ke0ff/hm133/hm151_keys_sm.jpg

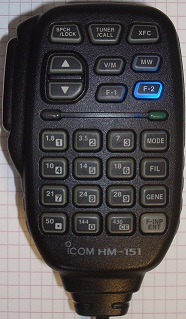
hm151_keys_sm.jpg
