ke0ff/hm133/hm151.jpg

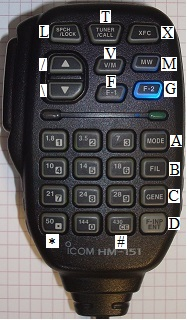
hm151.jpg
