ke0ff/hm133/F53x Software_HM133-WR_04/readme.txt

This project repo contains the SW and some of the HW artifacts for an SiLabs C8051F531-based MCU project to interface an ICOM HM-133 (or HM-151)
microphone to an older transciever using a wired remote protocol.  The source code was compiled and debugged using the Kiel/SiLabs tool-set.
