ke0ff/hm133/bt_host.jpg

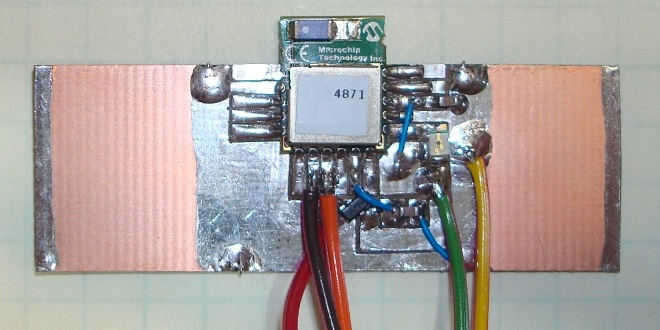
bt_host.jpg
