ke0ff/hm133/bt_remote.jpg

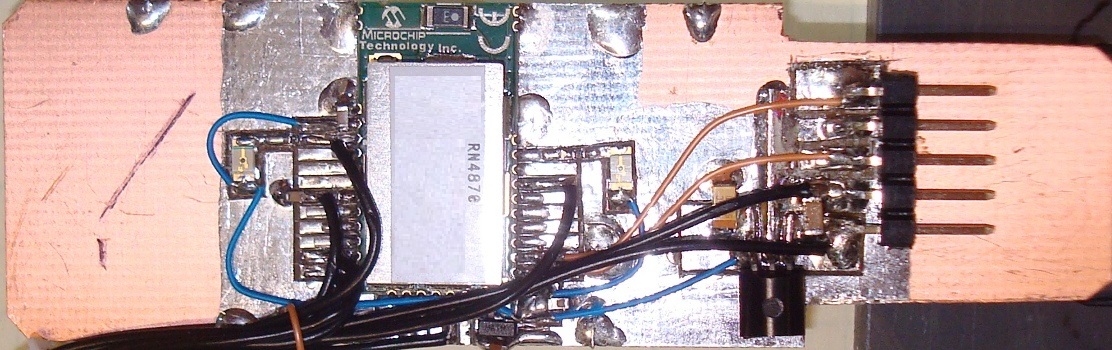
bt_remote.jpg
