ke0ff/hm133/ch901.jpg

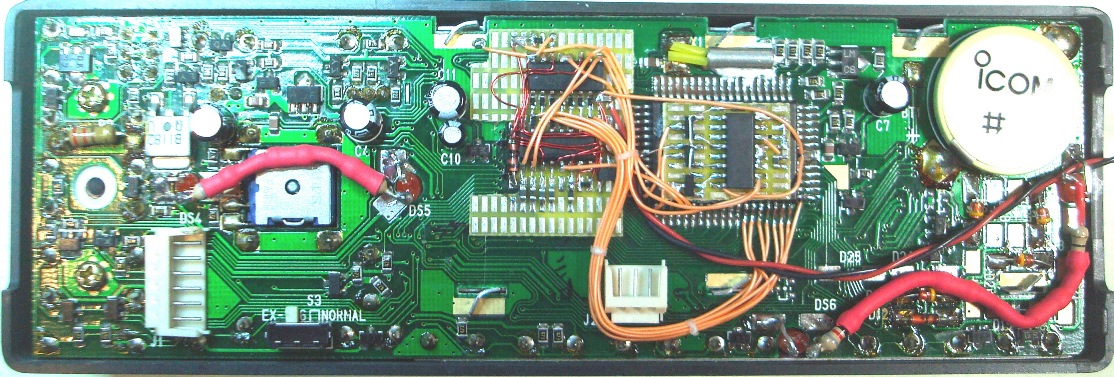
ch901.jpg
