ke0ff/hm133/ch901_schem.png

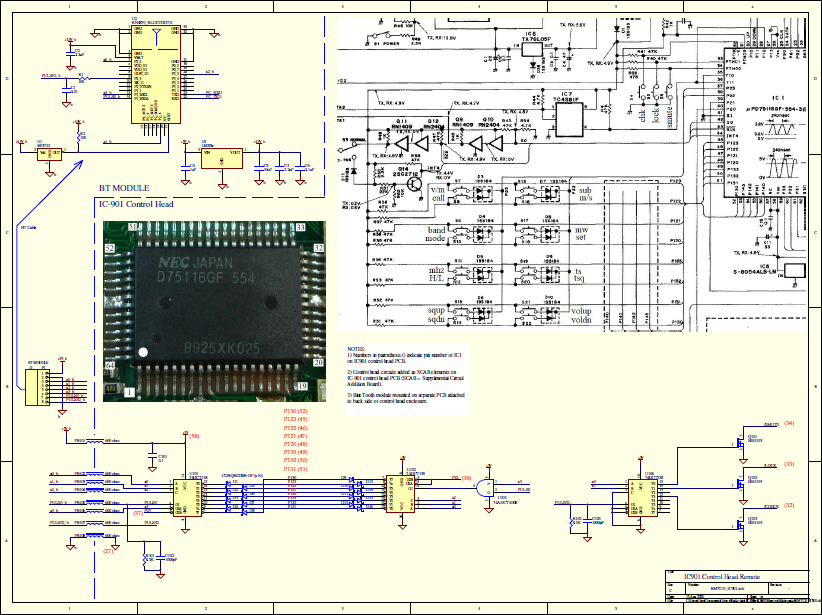
ch901_schem.png
