ke0ff/hm133/CH_901_exploded.jpg

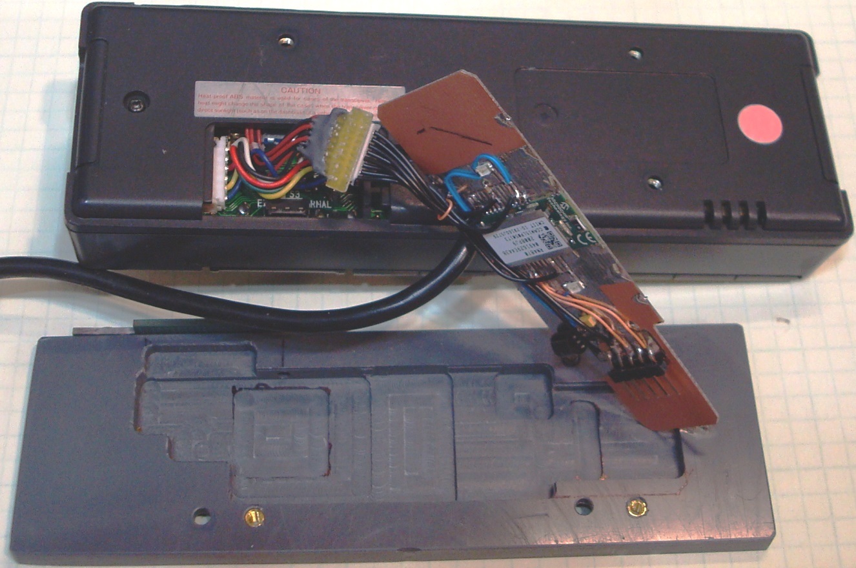
CH_901_exploded.jpg
