ke0ff/hm133/hm133bt.jpg

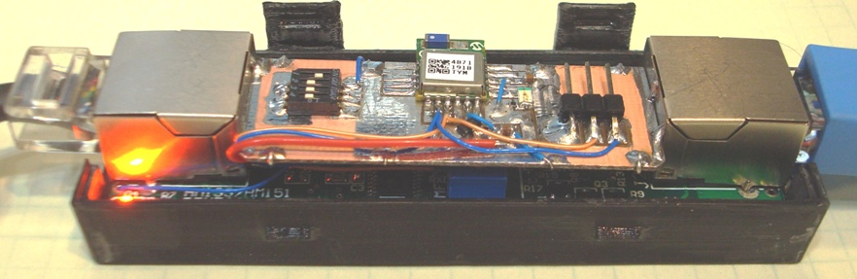
hm133bt.jpg
