ke0ff/hm133/hm133covered.jpg

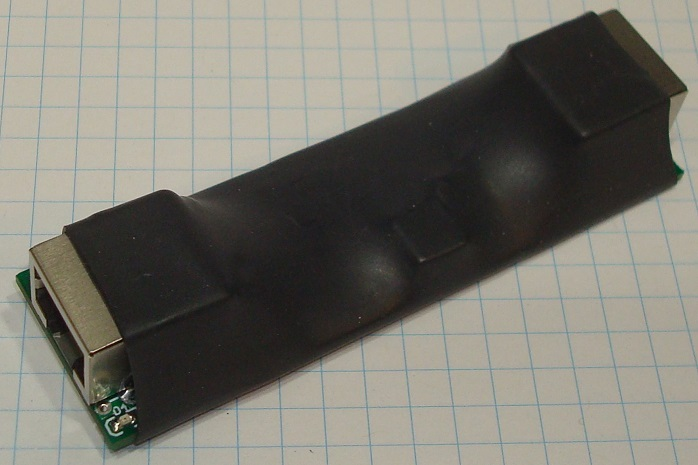
hm133covered.jpg
