ke0ff/hm133/hm133Dcovered.jpg

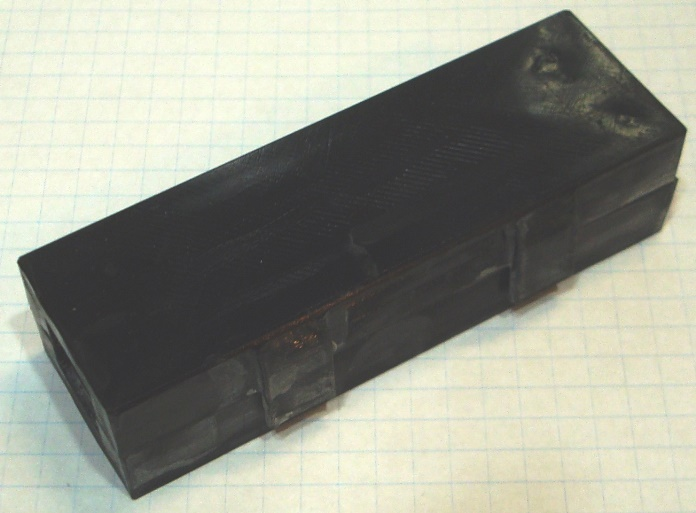
hm133Dcovered.jpg
