ke0ff/hm133/hm133front.jpg

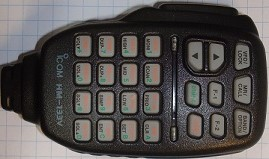
hm133front.jpg
