ke0ff/hm133/hm133sch-003thmb.jpg

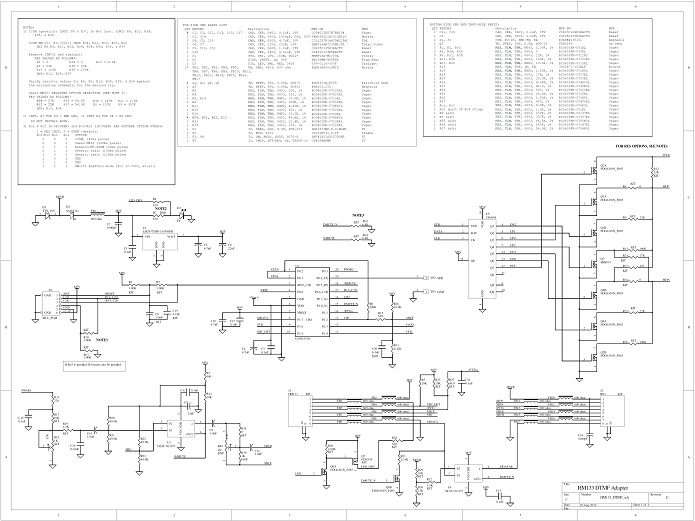
hm133sch-003thmb.jpg
