ke0ff/hm133/hm151front.jpg

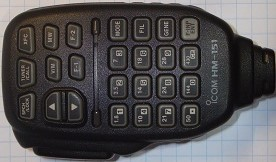
hm151front.jpg
