ke0ff/hm133/whole_smash.jpg

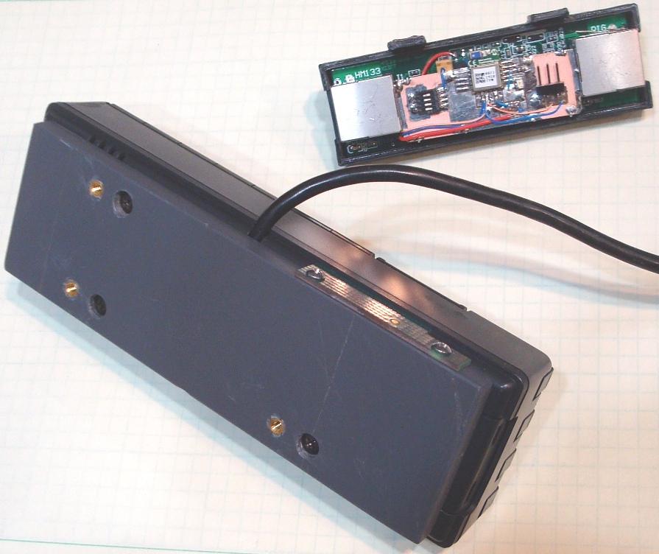
whole_smash.jpg
