ke0ff/hm133/F53x Software_HM133-WR_04/HM133WR_bom.xls

Part Type | Designator | Footprint | Description | Part Field 1 | Part Field 2 | Part Field 6 | Part Field 7
+3V3 | TP4 | TP-SMD-20x50-SQ |  | * | * | * | *
0 | R8 | 0402 |  | RC0603FR-071KL | Yageo | RES, FLM, THK, 0603, 1.00K, 1% | 402
0 | R9 | 0402 |  | RC0603FR-071KL | Yageo | RES, FLM, THK, 0603, 1.00K, 1% | 402
0 | R24 | 0402 |  | RC0805FR-071KL | Yageo | RES, FLM, THK, 0805, 1.00K, 1% | 402
0.1uF | C13 | 0603 | CAP, CER, CHIP | C0805C104K3RACTU | Kemet | CAP, CER, 0805, 0.1uF, 25V | 603
0.1uF | C12 | 0603 | CAP, CER, CHIP | C0805C104K3RACTU | Kemet | CAP, CER, 0805, 0.1uF, 25V | 603
0.1uF | C4 | 0603 | CAP, CER, CHIP | C0805C104K3RACTU | Kemet | CAP, CER, 0805, 0.1uF, 25V | 603
0.1uF | C1 | 0603 |  | * | * | * | 603
0.1uF | C11 | 0603 | CAP, CER, CHIP | C0805C104K3RACTU | Kemet | CAP, CER, 0805, 0.1uF, 25V | 603
0.1uF | C3 | 0603 | CAP, CER, CHIP | C0805C104K3RACTU | Kemet | CAP, CER, 0805, 0.1uF, 25V | 603
0.33uF | C15 | 0603 | CAP, CER, CHIP | C0805C104K3RACTU | Kemet | CAP, CER, 0805, 0.1uF, 25V | 603
1.00K | R2 | 0402 |  | RC00402FR-071KL | Yageo | RES, FLM, THK, 00402, 1.00K, 1% | 402
1.00K | R1 | 0402 |  | RC00402FR-071KL | Yageo | RES, FLM, THK, 00402, 1.00K, 1% | 402
1.0uF | C9 | 0805 |  | UMK212BJ105KG-T | Taiyo Yuden | CAP, CER, 0805, 1.0uF, 50V | 805
1.0uF | C8 | 0805 |  | UMK212BJ105KG-T | Taiyo Yuden | CAP, CER, 0805, 1.0uF, 50V | 805
1.8K | R19 | 0402 |  | RC00402FR-071K8L | Yageo | RES, FLM, THK, 00402, 1.80K, 1% | 402
1K | R18 | POT_3362H |  | * | * | * | 3362H
1uF | C10 | 0805 | CAP, CER, CHIP | * | * | * | 805
2 | R3 | 0603 |  | RC0603JR-072RL | Yageo | RES, FLM, THK, 0603, 2.00, 5% | 603
2.20K | R10 | 0402 |  | RC00402FR-072K2L | Yageo | RES, FLM, THK, 00402, 2.20K, 1% | 402
4.7uF | C5 | 1210 |  | * | * | * | 1210
5.2V | D5 | SOT23-A | DIODE, ZENER | * | * | * | SOT23
6.13K | R15 | 0402 |  | RC00402FR-076K13L | Yageo | RES, FLM, THK, 00402, 6.13K, 1% | 402
10K | R17 | 0402 |  | RC00402FR-0710KL | Yageo | RES, FLM, THK, 00402, 10.0K, 1% | 402
10uF | C14 | 1206 |  | * | * | * | 1206
20K | R4 | 0402 |  | RC00402FR-0720KL | Yageo | RES, FLM, THK, 00402, 20.0K, 1% | 402
20K | R5 | 0402 |  | RC00402FR-0712K7L | Yageo | RES, FLM, THK, 00402, 12.7K, 1% | 402
20K | R14 | 0402 |  | RC00402FR-0720KL | Yageo | RES, FLM, THK, 00402, 20.0K, 1% | 402
20K | R26 | 0402 |  | * | * | * | 402
20K | R25 | 0402 |  | RC00402FR-0720KL | Yageo | RES, FLM, THK, 00402, 20.0K, 1% | 402
22uF | C7 | 1206 |  | CL31B226MPHNNNE | 10V | * | 1206
22uF | C6 | 1206 |  | CL31B226MPHNNNE | 10V | * | 1206
49.9 | R27 | 0402 |  | RC00402FR-0749R9L | Yageo | RES, FLM, THK, 00402, 49.9, 1% | 402
49.9K | R21 | 0402 |  | RC00402FR-0749K9L | Yageo | RES, FLM, THK, 00402, 49.9K, 1% | 402
49.9K | R20 | 0402 |  | RC00402FR-0749K9L | Yageo | RES, FLM, THK, 00402, 49.9K, 1% | 402
49.9K | R22 | 0402 |  | RC00402FR-0749K9L | Yageo | RES, FLM, THK, 00402, 49.9K, 1% | 402
49.9K | R23 | 0402 |  | RC00402FR-0749K9L | Yageo | RES, FLM, THK, 00402, 49.9K, 1% | 402
74HCT1G08 | U6 | SOT-23-5 | Single Gate AND | * | * | * | SOT23-5
74LVC1G3157 | U5 | SOT-23-6 | IC, Analog SW, SPDT | SN74LVC1G3157DCKR | * | * | SOT23-6
74LVC1G3157 | U3 | SOT-23-6 | IC, Analog SW, SPDT | SN74LVC1G3157DCKR | * | * | SOT23-6
102K | R6 | 0402 |  | RC00402FR-07102KL | Yageo | RES, FLM, THK, 00402, 102K, 1% | 402
200K | R29 | 0402 |  | * | * | * | 402
200K | R30 | 0402 |  | * | * | * | 402
470 | R13 | 0402 |  | RC0603FR-071KL | Yageo | RES, FLM, THK, 0603, 1.00K, 1% | 402
470 | R12 | 0603 |  | RC00402FR-07470RL | Yageo | RES, FLM, THK, 00402, 470, 1% | 402
600 ohm | FB6 | 0603 |  | BLM31PG601SN1L | Murata | FB, SMD, 1206, 600 ohm | 603
600 ohm | FB5 | 0603 |  | BLM31PG601SN1L | Murata | FB, SMD, 1206, 600 ohm | 603
600 ohm | FB7 | 0603 |  | BLM31PG601SN1L | Murata | FB, SMD, 1206, 600 ohm | 603
600 ohm | FB9 | 0603 |  | BLM31PG601SN1L | Murata | FB, SMD, 1206, 600 ohm | 603
600 ohm | FB8 | 0603 |  | BLM31PG601SN1L | Murata | FB, SMD, 1206, 600 ohm | 603
600 ohm | FB12 | 0603 |  | BLM31PG601SN1L | Murata | FB, SMD, 1206, 600 ohm | 603
600 ohm | FB13 | 0603 |  | BLM31PG601SN1L | Murata | FB, SMD, 1206, 600 ohm | 603
600 ohm | FB14 | 0603 |  | BLM31PG601SN1L | Murata | FB, SMD, 1206, 600 ohm | 603
600 ohm | FB1 | 0603 |  | BLM31PG601SN1L | Murata | FB, SMD, 1206, 600 ohm | 603
600 ohm | FB10 | 0603 |  | BLM31PG601SN1L | Murata | FB, SMD, 1206, 600 ohm | 603
600 ohm | FB11 | 0603 |  | BLM31PG601SN1L | Murata | FB, SMD, 1206, 600 ohm | 603
600 ohm | FB2 | 0603 |  | BLM31PG601SN1L | Murata | FB, SMD, 1206, 600 ohm | 603
600 ohm | FB3 | 0603 |  | BLM31PG601SN1L | Murata | FB, SMD, 1206, 600 ohm | 603
600 ohm | FB4 | 0603 |  | BLM31PG601SN1L | Murata | FB, SMD, 1206, 600 ohm | 603
600 ohm | FB16 | 0603 |  | BLM31PG601SN1L | Murata | FB, SMD, 1206, 600 ohm | 603
600 ohm | FB15 | 0603 |  | BLM31PG601SN1L | Murata | FB, SMD, 1206, 600 ohm | 603
600 ohm | FB17 | 0603 |  | BLM31PG601SN1L | Murata | FB, SMD, 1206, 600 ohm | 603
620 | R16 | 0402 |  | RC00402FR-07620RL | Yageo | RES, FLM, THK, 00402, 620, 1% | 402
620 | R31 | 0402 |  | RC00402FR-07280RL | Yageo | RES, FLM, THK, 00402, 280, 1% | 402
820 | R7 | 0603 |  | RC0603FR-07820RL | Yageo | * | 603
820 | R28 | 0603 |  | RC0603FR-07820RL | Yageo | * | 603
1000pF | C2 | 0603 |  | GRM1885C1H102JA01D | Murata | CAP, CER, 0603, 1000pF, COG, 50V | 603
BSH103 | Q2 | SOT23-A |  | NDS355AN | Fairchild Semi. | TR, NFET, 30V, 1.7A, SOT23 | SOT23
BSH103 | Q3 | SOT23-A |  | NDS355AN | Fairchild Semi. | TR, NFET, 30V, 1.7A, SOT23 | SOT23
BSH103 | Q1 | SOT23-A |  | NDS355AN | Fairchild Semi. | TR, NFET, 30V, 1.7A, SOT23 | SOT23
BSH103 | Q4 | SOT23-A |  | NDS355AN | Fairchild Semi. | TR, NFET, 30V, 1.7A, SOT23 | SOT23
BSH103 | Q5 | SOT23-A |  | * | * | * | SOT23
C8051F530 | U2 | TSSOP-20 | IC, MCU, 8051, F531 | C8051F531-C-IT | SiLabs | IC, MCU, 8051 | TSSOP-20
DNP | R11 | 0402 |  | DNP |  | RES, FLM, THK, 00402, 1.00K, 1% | 402
FDN358 | Q6 | SOT23-A | P-CHAN MOS FET | * | * | * | SOT23
GND | TP3 | TP-SMD-20x50-SQ |  | * | * | * | *
HM133 | J1 | RJ-45_RJLSE41389101 | Connector, RJ-45, 42 mtg holes | * | * | * | RJ-45
LM2937IMP-3.3/NOPB | U1 | SOT223 | LM2937ET-3.3 | * | * | * | SOT223
LM4040-2.5V | D6 | SOT23-A | DIODE, ZENER | * | * | * | SOT23
MCU_PGM | P1 | CON_1.25MM_6P | 6-PIN JTAG HDR | 53398-0671 (V) | 53261-0671 (RA) |  | MLX_1.25MM_6P
PWR | D4 | 0805-LED | LED, SMD | * | * | * | 805
RIG | J2 | RJ-45_RJLSE41389101 | Connector, RJ-45, 42 mtg holes | * | * | * | RJ-45
RXD | TP2 | TP-SMD-20x50-SQ |  | * | * | * | *
SS26T3G | D2 | SOD123 | Schottky Diode | SS26T3G | ON Semi | DIOD, SHTKY, 2A, 60V | SOD123
TS12A4515 | U4 | SOT-23-5 | IC, SW, ANLG, SPST, NC | * | * | * | SOT23-5
TVS, 8V | D1 | DO219 | Tranzorb Diode | DNP | * | TVS, UNI, 16V, 200W, DO219 | DO219
TXD | TP1 | TP-SMD-20x50-SQ |  | * | * | * | *
