ke0ff/hm133/(list of files, cad)

Other CAD files:
F53x Software_HM133-WR_04/main.OBJ
main.OBJ
F53x Software_HM133-WR_04/sine_c.OBJ
sine_c.OBJ
f300_init.OBJ
F53x Software_HM133-WR_04/wired_rmt.OBJ
F53x Software_HM133-WR_04/serial.OBJ
STARTUP.OBJ
F53x Software_HM133-WR_04/INIT.OBJ
INIT.OBJ
F53x Software_HM133-WR_04/f300_init.OBJ
F53x Software_HM133-WR_04/STARTUP.OBJ
