ke0ff/hm133/ch901_schem.pdf

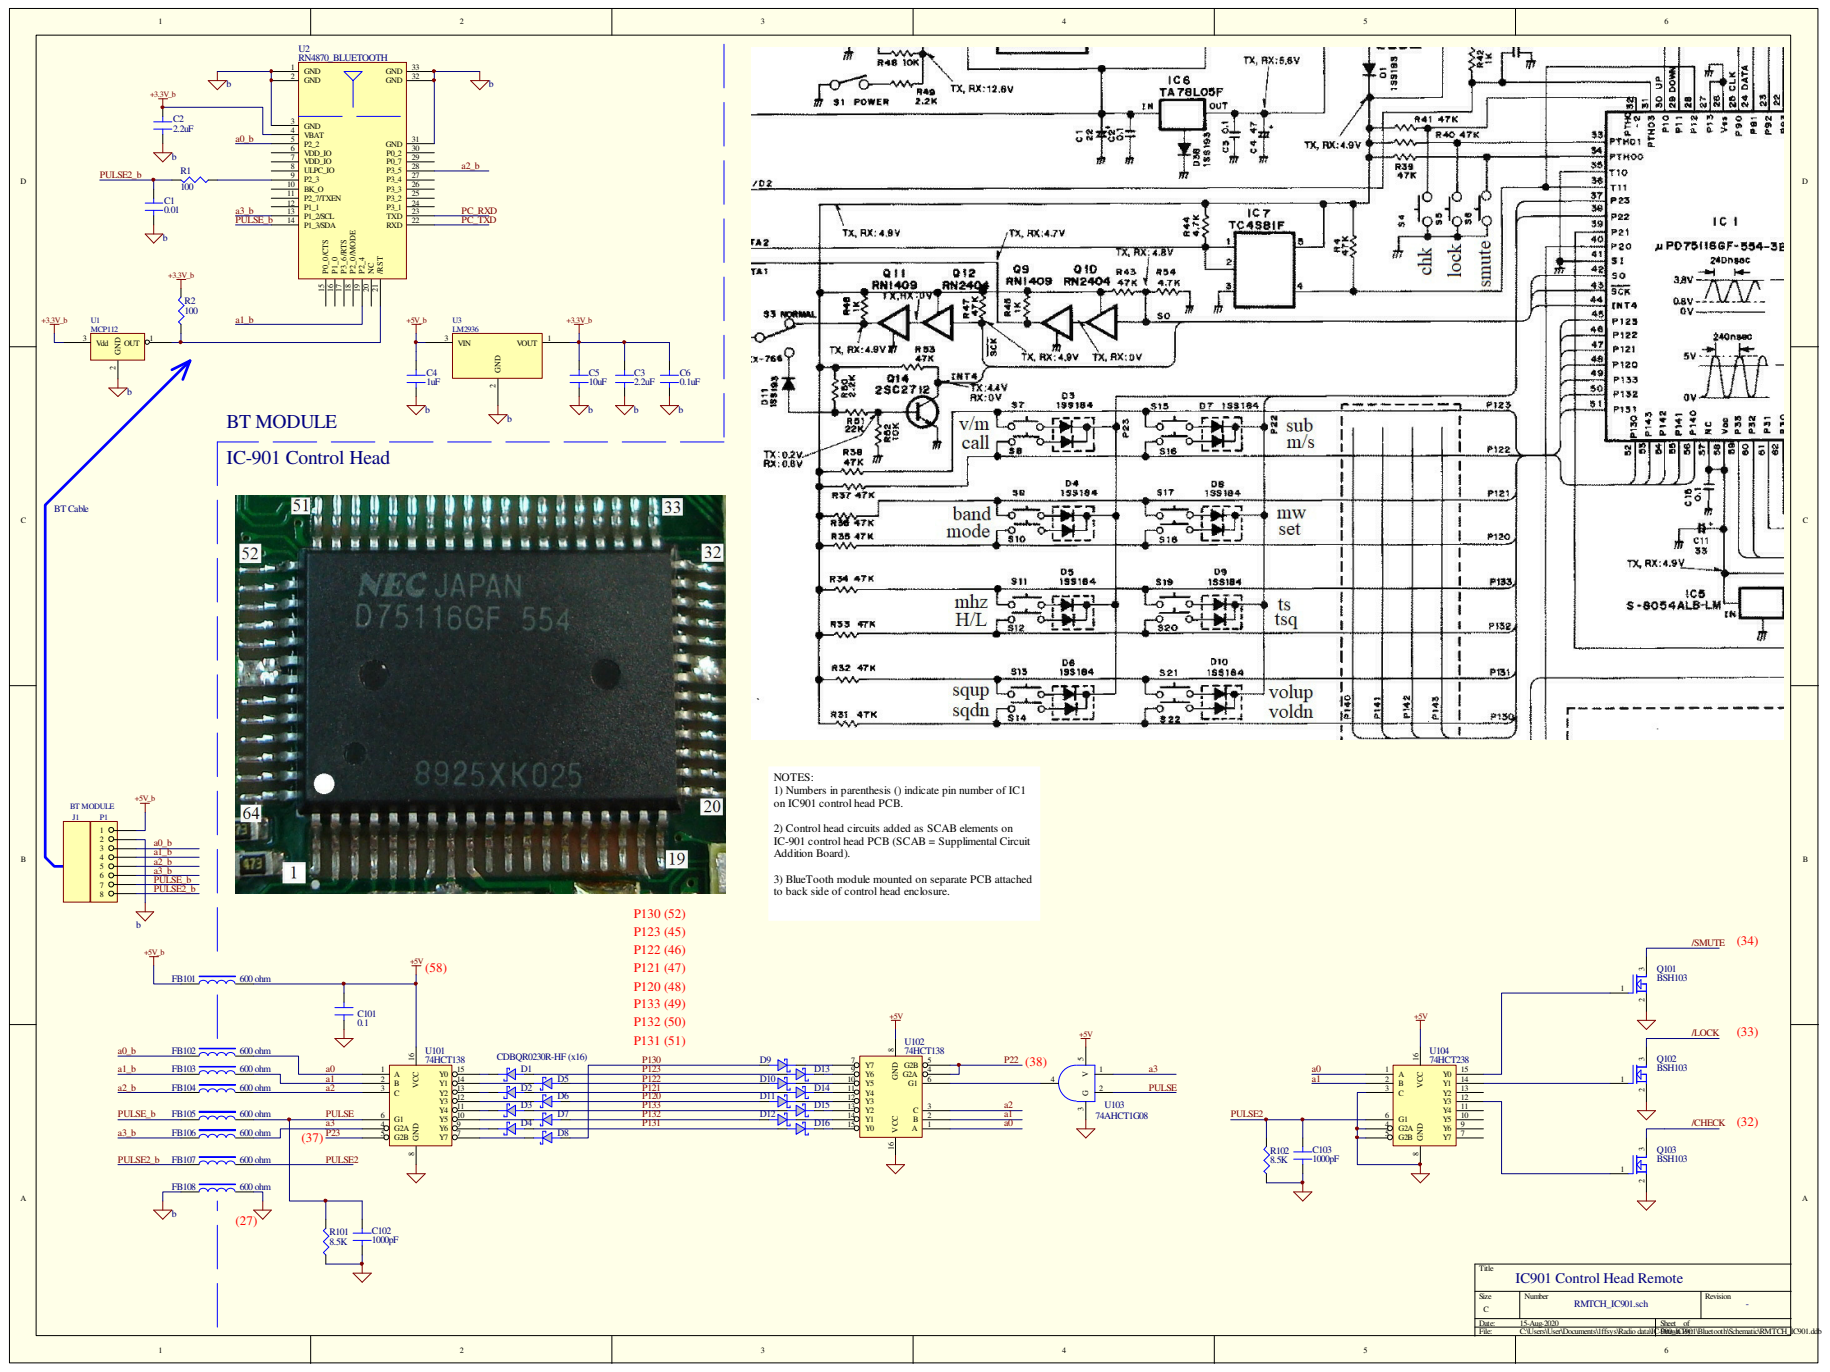
[picture p29: page 1]

NOTES:
1) Numbers in parenthesis () indicate pin number of IC1
on IC901 control head PCB.

2) Control head circuits added as SCAB elements on
IC-901 control head PCB (SCAB = Supplimental Circuit
Addition Board).

3) BlueTooth module mounted on separate PCB attached
to back side of control head enclosure.
