ke0ff/hm133/hm133dtmfschem.pdf

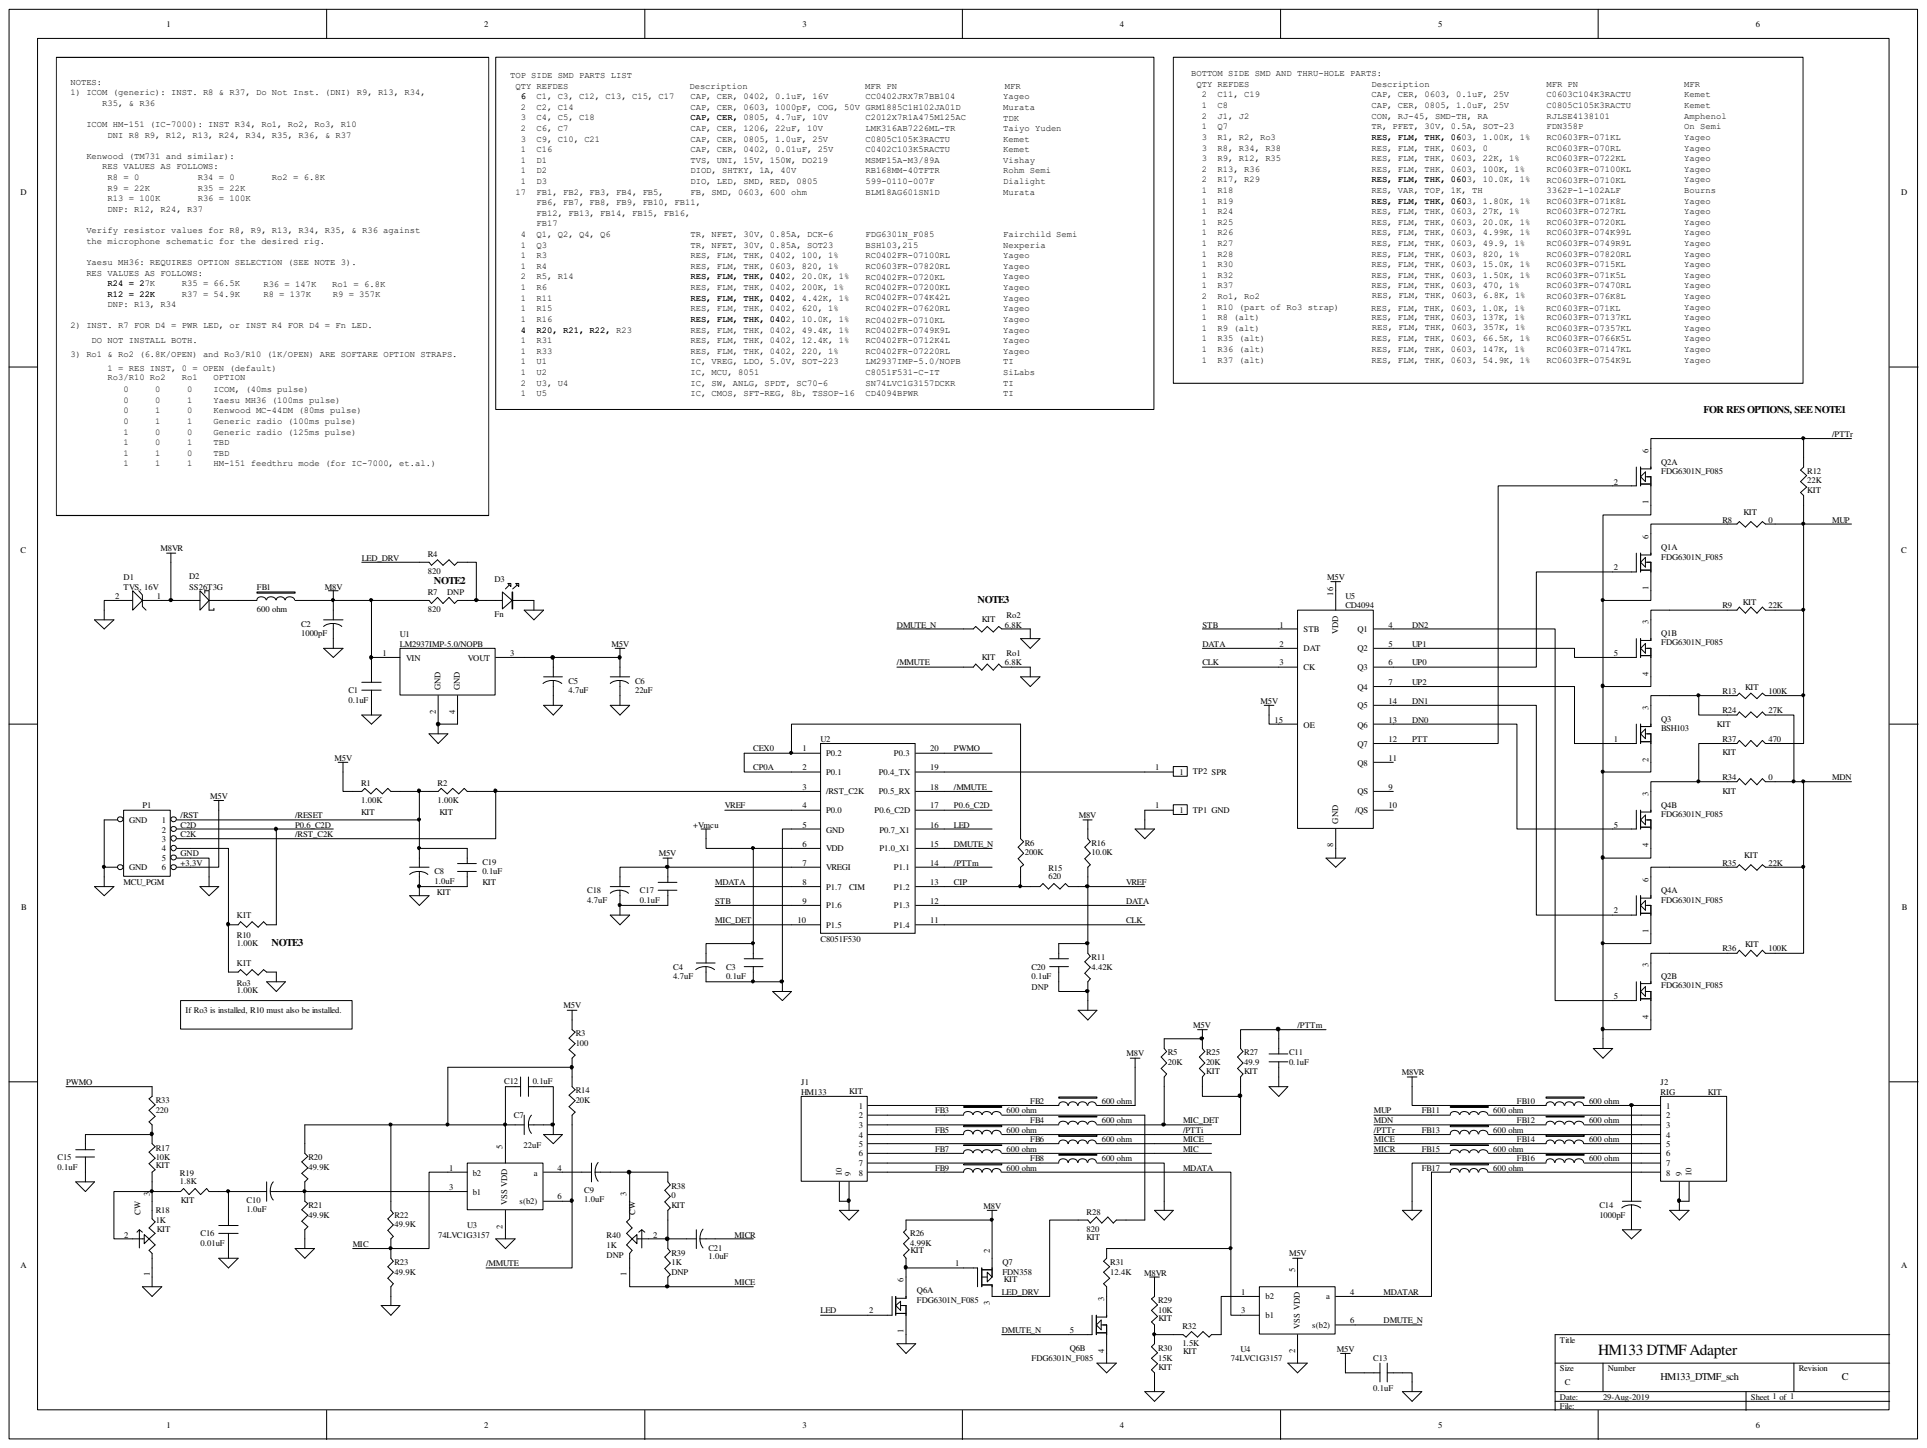
[picture p30: page 1]

NOTES:
1) ICOM (generic): INST. R8 & R37, Do Not Inst. (DNI) R9, R13, R34,
ICOM HM-151 (IC-7000): INST R34, Ro1, Ro2, Ro3, R10
DNI R8 R9, R12, R13, R24, R34, R35, R36, & R37
Kenwood (TM731 and similar):
RES VALUES AS FOLLOWS:
DNP: R12, R24, R37
Verify resistor values for R8, R9, R13, R34, R35, & R36 against
the microphone schematic for the desired rig.
Yaesu MH36: REQUIRES OPTION SELECTION (SEE NOTE 3).
DNP: R13, R34
2) INST. R7 FOR D4 = PWR LED, or INST R4 FOR D4 = Fn LED.
DO NOT INSTALL BOTH.
3) Ro1 & Ro2 (6.8K/OPEN) and Ro3/R10 (1K/OPEN) ARE SOFTARE OPTION STRAPS.
1 = RES INST, 0 = OPEN (default)
Ro3/R10 Ro2 Ro1 OPTION

ICOM, (40ms pulse)
Yaesu MH36 (100ms pulse)
Kenwood MC-44DM (80ms pulse)
Generic radio (100ms pulse)
Generic radio (125ms pulse)
TBD
HM-151 feedthru mode (for IC-7000, et.al.)

FOR RES OPTIONS, SEE NOTE1

If Ro3 is installed, R10 must also be installed.
