ke0ff/hm133/F53x Software_HM133-WR_04/HM133WR_schem.pdf

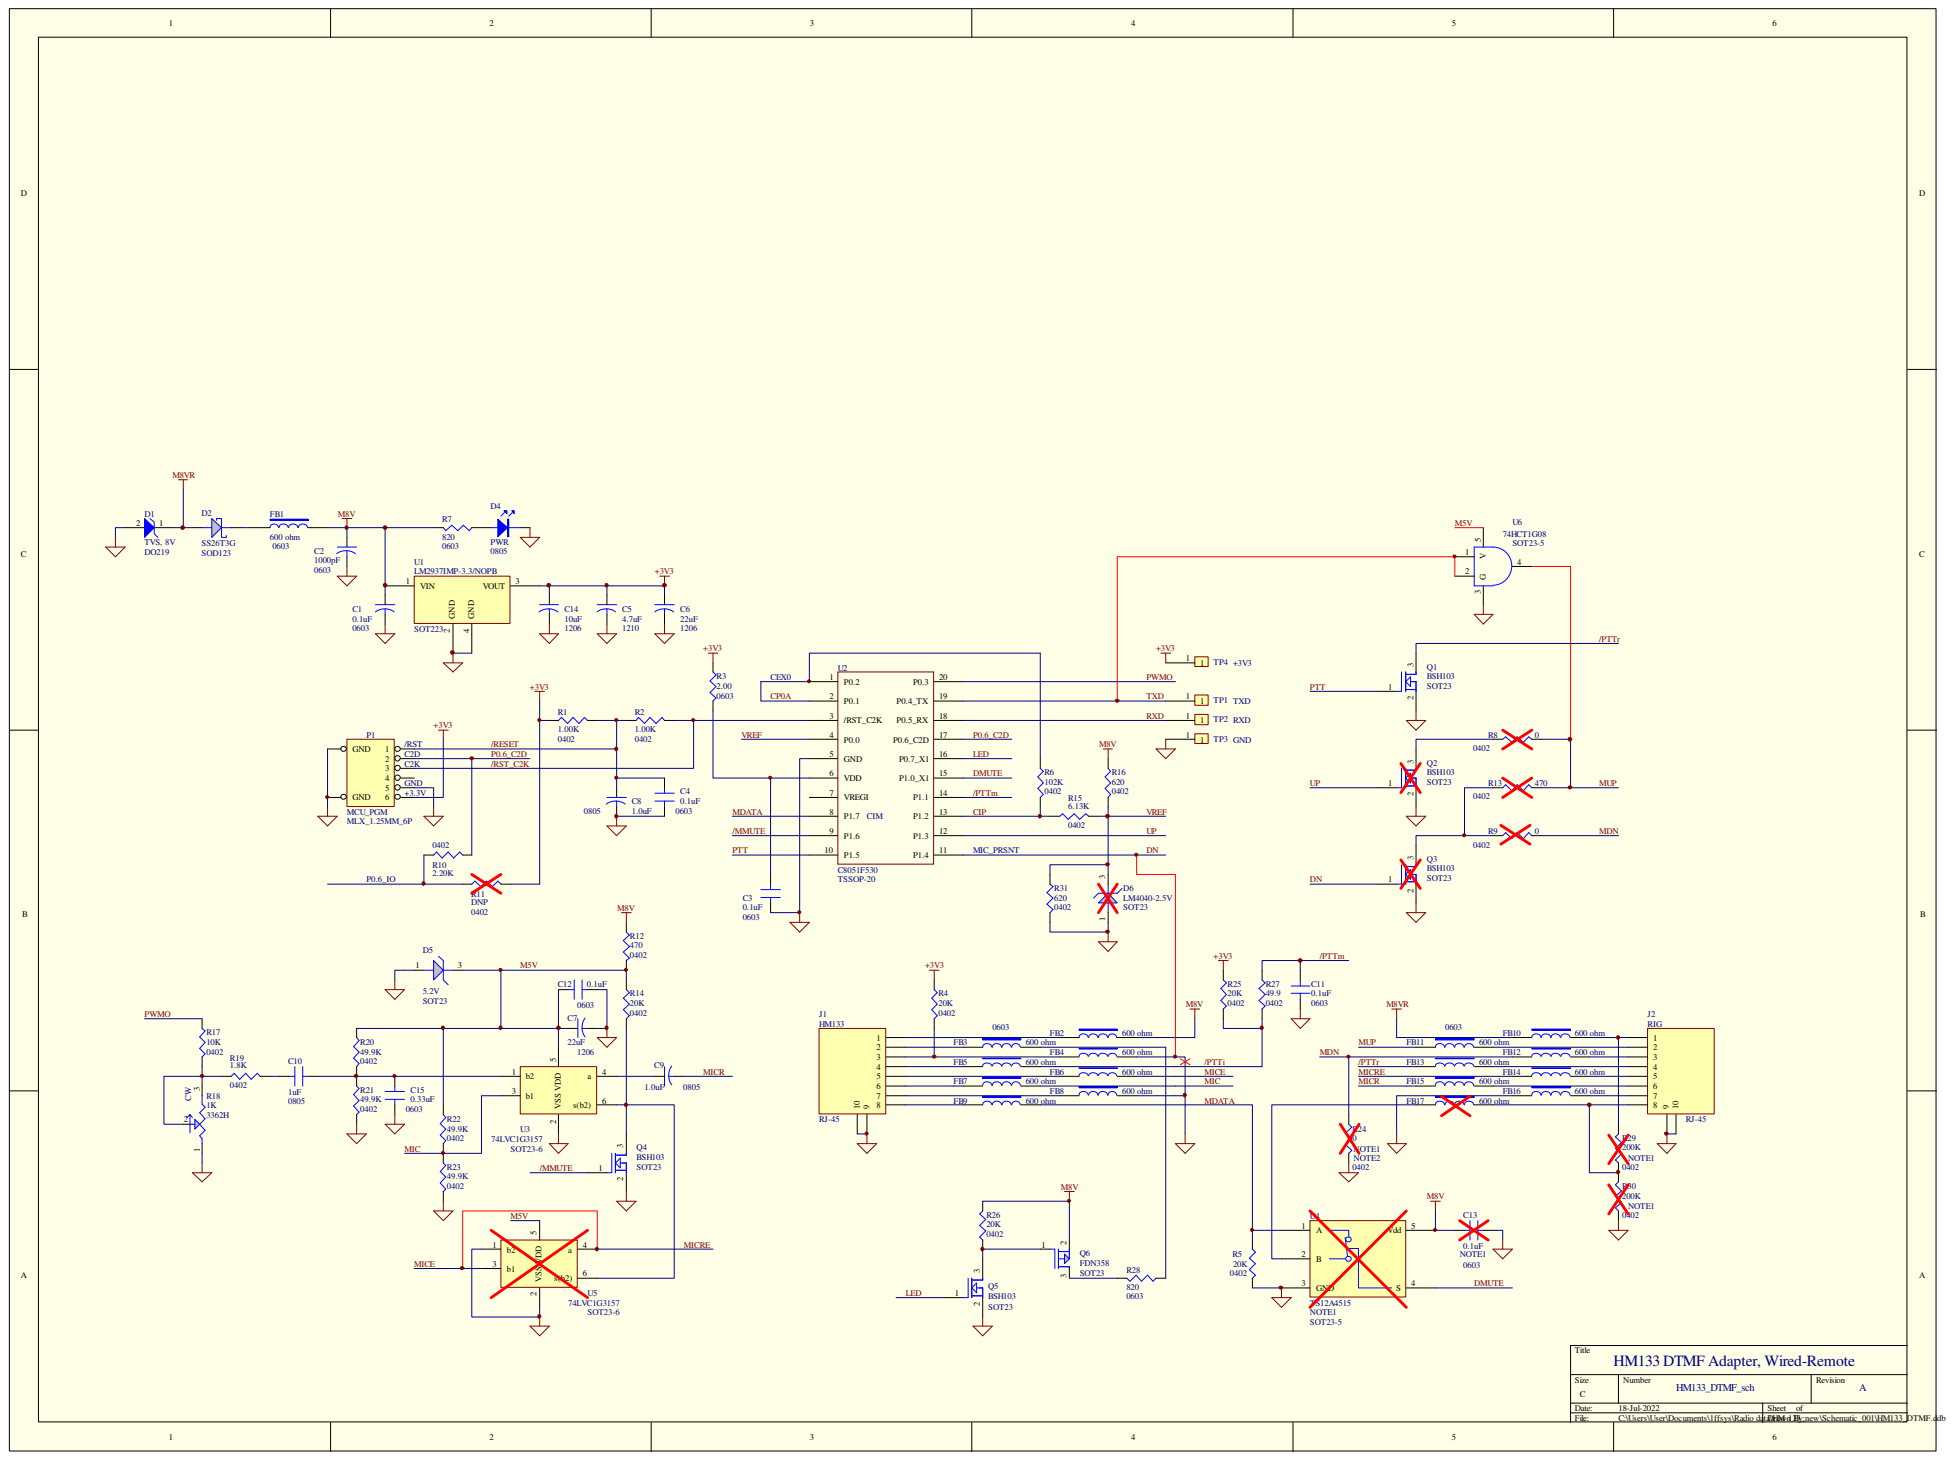
[picture p31: page 1]

Title
HM133 DTMF Adapter, Wired-Remote
