ke0ff/hm133/(commit log)

2019-10-22 Add files via upload
    Initial project upload
    [INIT.OBJ, STARTUP.OBJ, f300_init.OBJ, main.OBJ, sine_c.OBJ]
2020-03-14 V3 updates
    * *** REV 03 ***
    * 03-10-20 jmh: Modified pulse() to accept U16 pulse timer (modified pulse timer also). Rig array
    * still stores U8, so it must be cast when the rig type is read on power-up.
    * Modified ICOM mode to use MR(TUNER) as scan up, and F-1(V/M) as scan down. These
    * keys instantiate an 800ms pulse on up or dn to start the scan mode.
    * Modified ICOM pulse period to 45 ms (was 40).
    * Added named rig types for Kenwood and generic 100 and 125.
    * Fixed several code snippets for "VERS == 1" build case.
    [init.h, main.c]
2022-06-28 HM-133 Wired Remote Initial Commit
    Same premise as the BT version, but simpler. Uses UP/DN signal to carry data. Remote host re-creates the up/dn from button messages. Targeted at both the IC-900 and IC-901.
    [INIT.OBJ, STARTUP.OBJ, f300_init.OBJ, main.OBJ, serial.OBJ, sine_c.OBJ, wired_rmt.OBJ]
2022-07-01 V0.1 Commit
    Bench-debug build -- Ready for field trials...
    [INIT.OBJ, STARTUP.OBJ, f300_init.OBJ, main.OBJ, serial.OBJ, sine_c.OBJ, wired_rmt.OBJ]
2022-07-19 As-built commit for HM133WR
    Schem and BOM for as-built prototype
    [HM133WR_bom.xls]
